iorodeo/buckpuck_current_controller/images/buckpuck_current_controller_front.jpg

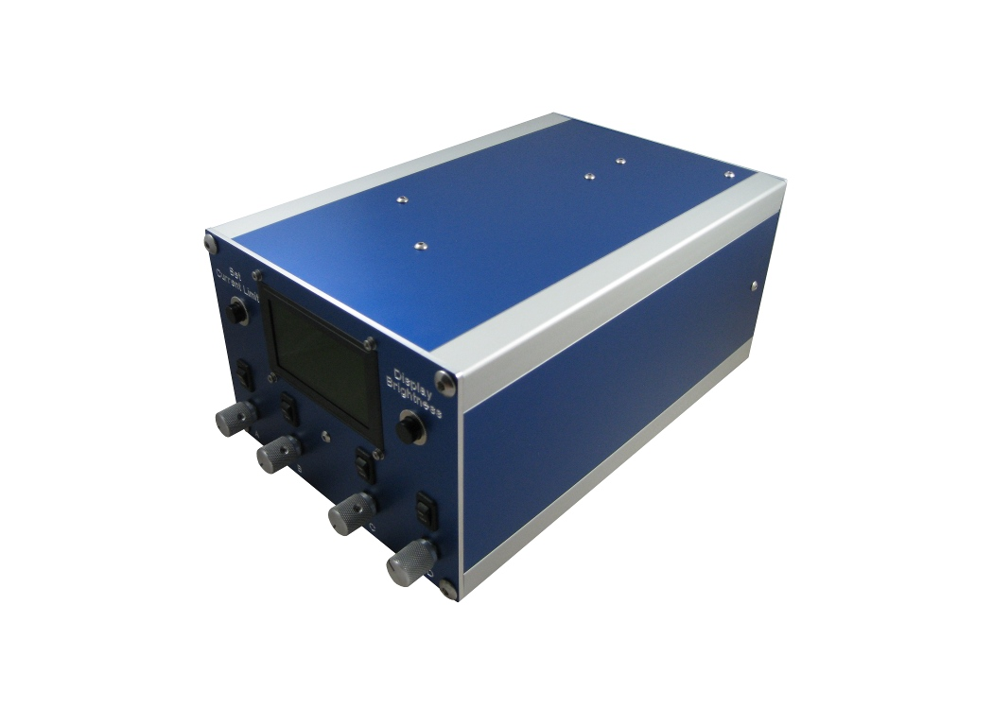
images/buckpuck_current_controller_front.jpg
