iorodeo/buckpuck_current_controller/datasheets/current_sensor_board.png

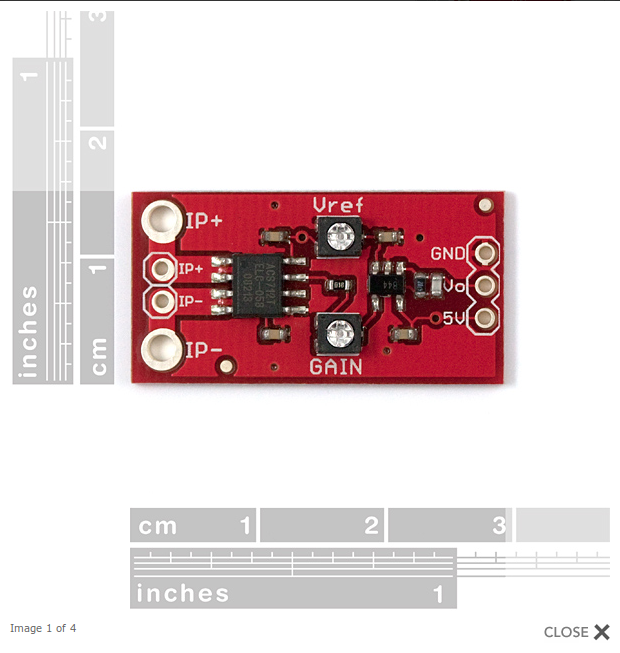
datasheets/current_sensor_board.png
