iorodeo/buckpuck_current_controller/images/buckpuck_current_controller_back.jpg

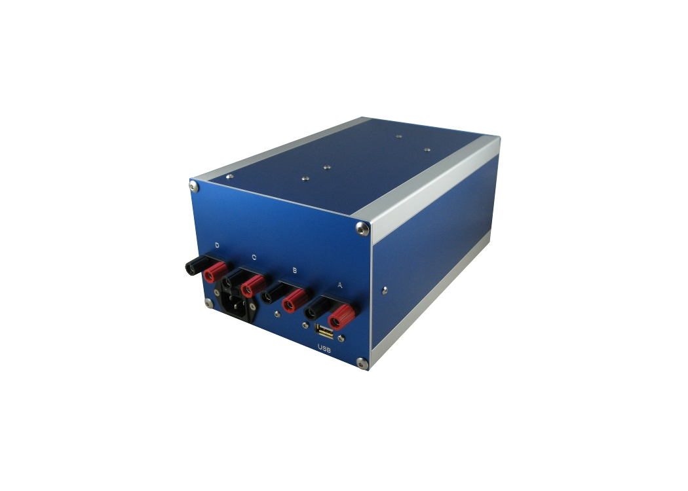
images/buckpuck_current_controller_back.jpg
