iorodeo/buckpuck_current_controller/images/buckpuck_current_controller_inside.jpg

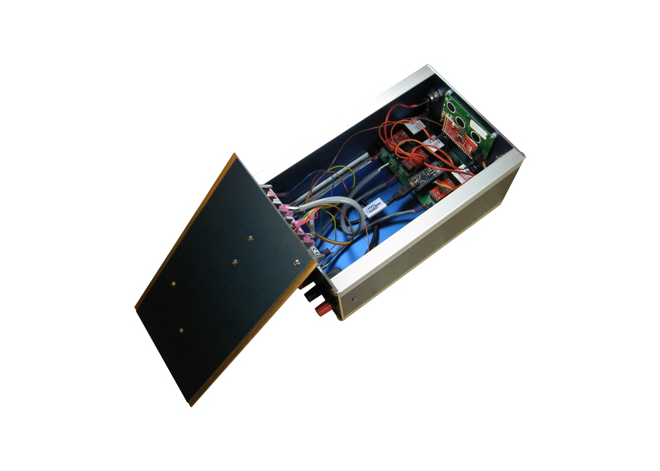
images/buckpuck_current_controller_inside.jpg
