iorodeo/buckpuck_current_controller/enclosure/enclosure_back.dxf

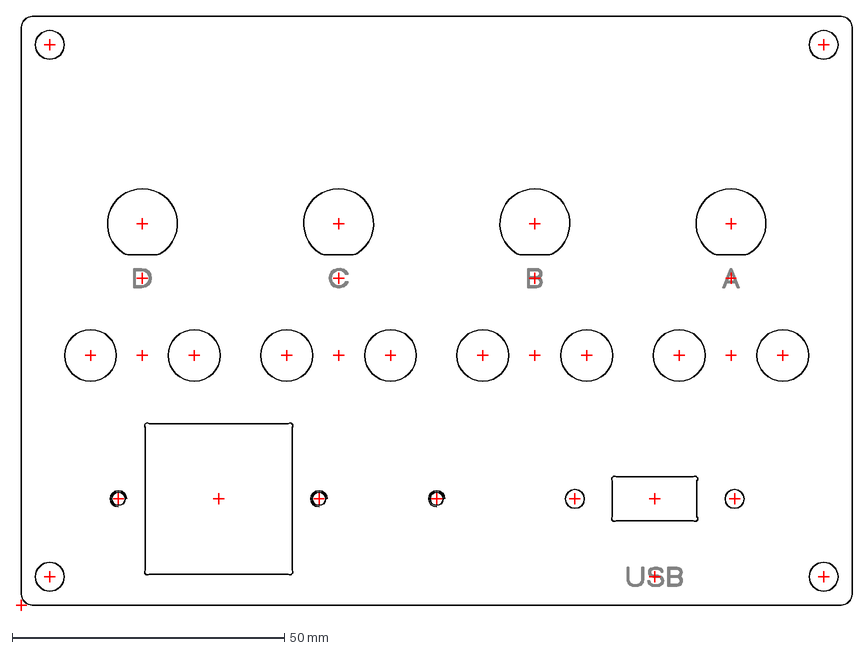
[picture p5: CAD file, 2011-09-08]
enclosure/enclosure_back.dxf
153.4 x 109.0 mm
