iorodeo/buckpuck_current_controller/datasheets/dac_wiring.gif

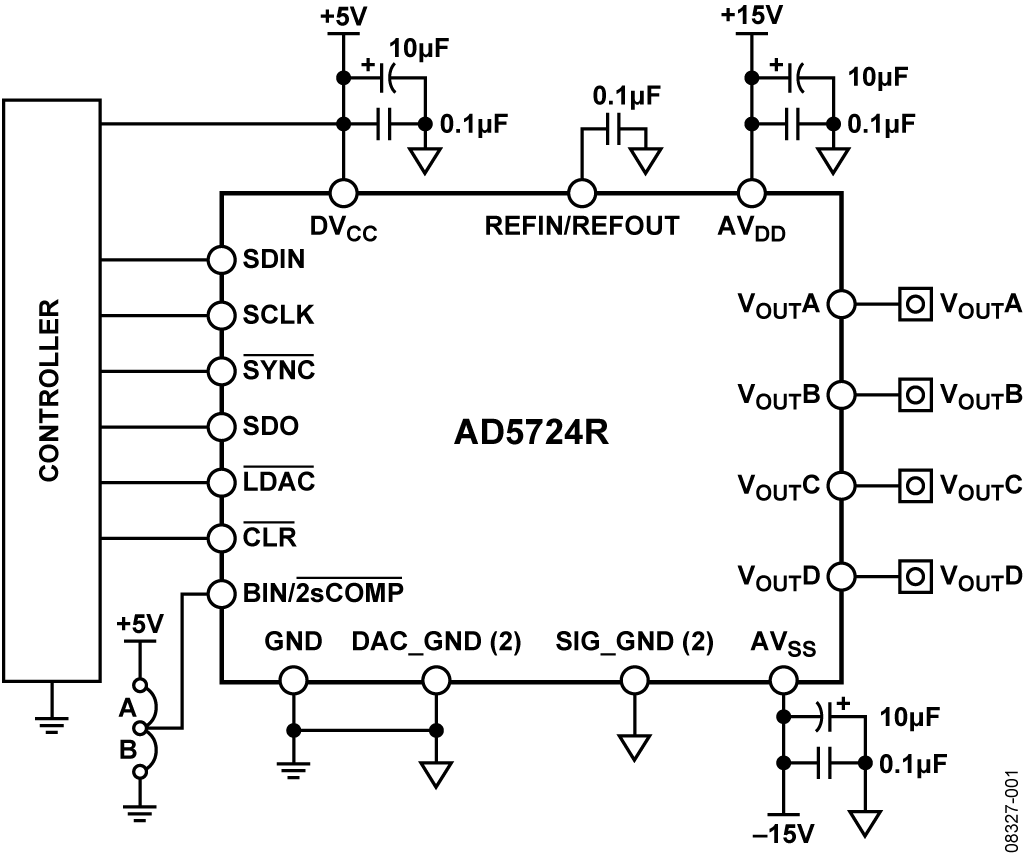
datasheets/dac_wiring.gif
