iorodeo/buckpuck_current_controller/(list of files, drawings)

Other design files:
pcb/buckpuck_current_controller.dsn
