iorodeo/buckpuck_current_controller/pcb/buckpuck_current_controller.sch

## KiCad design pcb/buckpuck_current_controller.sch (2011-08-04)

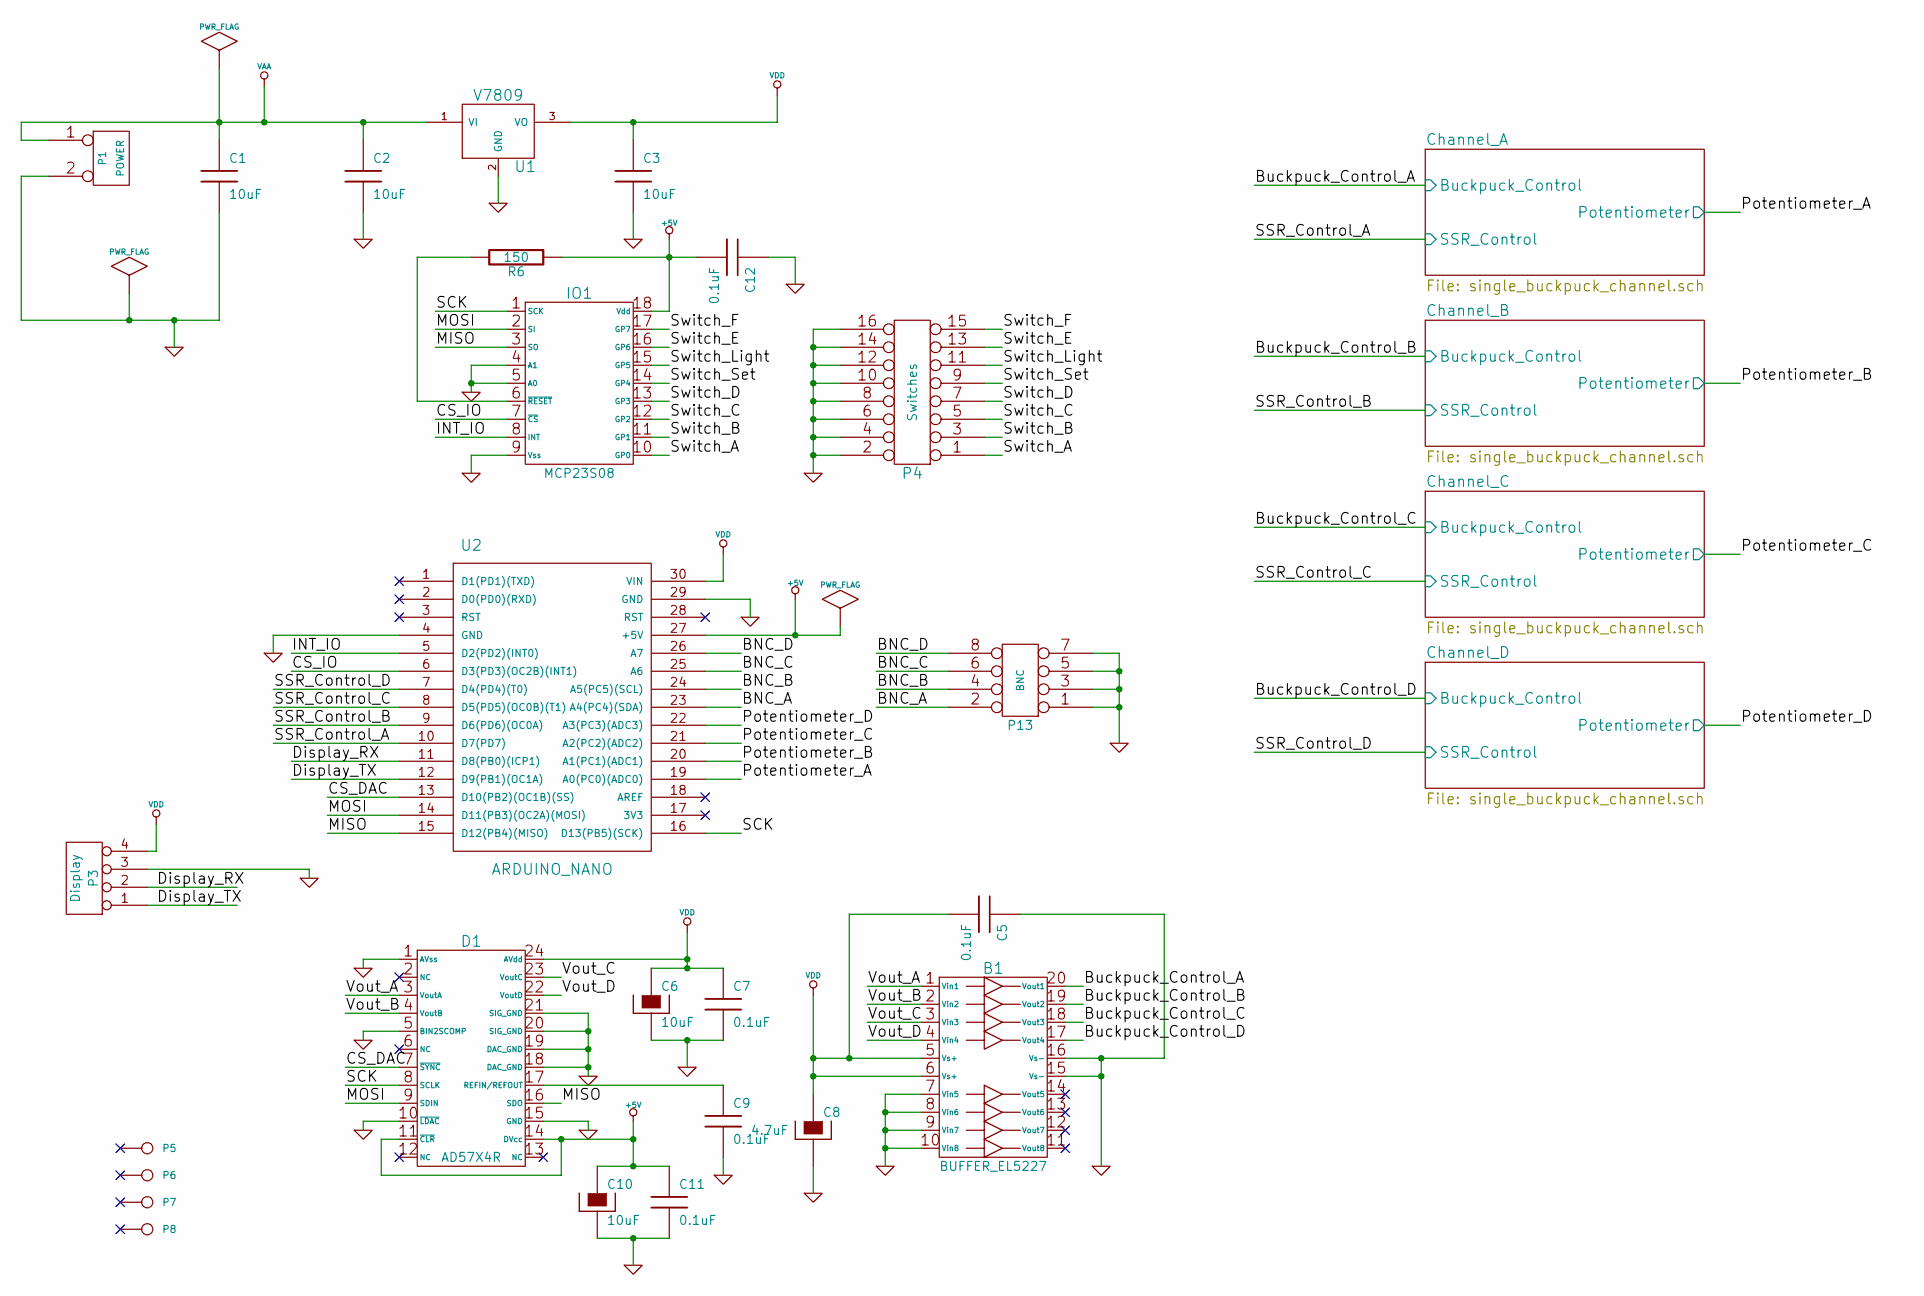
[picture p7: schematic buckpuck_current_controller.sch]

Parts:
B1: BUFFER_EL5227
C1, C2, C3, C6, C10: 10uF
C5, C7, C9, C11, C12: 0.1uF
C8: 4.7uF
D1: AD57X4R
IO1: MCP23S08
P1: POWER
P3: Display
P4: Switches
P5, P6, P7, P8: CONN_1
P13: BNC
R6: 150
U1: V7809
U2: ARDUINO_NANO

Connections:
+5V: C10.1, C11.1, C12.2, D1.11 (~CLR), D1.14 (DVcc), IO1.18 (Vdd), R6.1, U2.27 (+5V)
BNC_A: P13.2, U2.23 (A4(PC4)(SDA))
BNC_B: P13.4, U2.24 (A5(PC5)(SCL))
BNC_C: P13.6, U2.25 (A6)
BNC_D: P13.8, U2.26 (A7)
Buckpuck_Control_A: B1.20 (Vout1)
Buckpuck_Control_B: B1.19 (Vout2)
Buckpuck_Control_C: B1.18 (Vout3)
Buckpuck_Control_D: B1.17 (Vout4)
CS_DAC: D1.7 (~SYNC), U2.13 (D10(PB2)(OC1B)(SS))
CS_IO: IO1.7 (~CS), U2.6 (D3(PD3)(OC2B)(INT1))
Display_RX: P3.2, U2.11 (D8(PB0)(ICP1))
Display_TX: P3.1, U2.12 (D9(PB1)(OC1A))
GND: B1.7 (Vin5), B1.8 (Vin6), B1.9 (Vin7), B1.10 (Vin8), B1.15 (Vs-), B1.16 (Vs-), C1.2, C2.2, C3.2, C5.1, C6.2, C7.2, C8.2, C9.2, C10.2, C11.2, C12.1, D1.1 (AVss), D1.5 (BIN2SCOMP), D1.10 (~LDAC), D1.15 (GND), D1.18 (DAC_GND), D1.19 (DAC_GND), D1.20 (SIG_GND), D1.21 (SIG_GND), IO1.4 (A1), IO1.5 (A0), IO1.9 (Vss), P1.2 (PM), P3.3, P4.2, P4.4, P4.6, P4.8, P4.10, P4.12, P4.14, P4.16, P13.1, P13.3, P13.5, P13.7, U1.2 (GND), U2.4 (GND), U2.29 (GND)
INT_IO: IO1.8 (INT), U2.5 (D2(PD2)(INT0))
MISO: D1.16 (SDO), IO1.3 (SO), U2.15 (D12(PB4)(MISO))
MOSI: D1.9 (SDIN), IO1.2 (SI), U2.14 (D11(PB3)(OC2A)(MOSI))
unnamed: C9.1, D1.17 (REFIN/REFOUT)
unnamed: IO1.6 (~RESET), R6.2
Potentiometer_A: U2.19 (A0(PC0)(ADC0))
Potentiometer_B: U2.20 (A1(PC1)(ADC1))
Potentiometer_C: U2.21 (A2(PC2)(ADC2))
Potentiometer_D: U2.22 (A3(PC3)(ADC3))
SCK: D1.8 (SCLK), IO1.1 (SCK), U2.16 (D13(PB5)(SCK))
SSR_Control_A: U2.10 (D7(PD7))
SSR_Control_B: U2.9 (D6(PD6)(OC0A))
SSR_Control_C: U2.8 (D5(PD5)(OC0B)(T1))
SSR_Control_D: U2.7 (D4(PD4)(T0))
Switch_A: IO1.10 (GP0), P4.1
Switch_B: IO1.11 (GP1), P4.3
Switch_C: IO1.12 (GP2), P4.5
Switch_D: IO1.13 (GP3), P4.7
Switch_E: IO1.16 (GP6), P4.13
Switch_F: IO1.17 (GP7), P4.15
Switch_Light: IO1.15 (GP5), P4.11
Switch_Set: IO1.14 (GP4), P4.9
VAA: C1.1, C2.1, P1.1, U1.1 (VI)
VDD: B1.5 (Vs+), B1.6 (Vs+), C3.1, C5.2, C6.1, C7.1, C8.1, D1.24 (AVdd), P3.4, U1.3 (VO), U2.30 (VIN)
Vout_A: B1.1 (Vin1), D1.3 (VoutA)
Vout_B: B1.2 (Vin2), D1.4 (VoutB)
Vout_C: B1.3 (Vin3), D1.23 (VoutC)
Vout_D: B1.4 (Vin4), D1.22 (VoutD)
