iorodeo/buckpuck_current_controller/pcb/single_buckpuck_channel.sch

## KiCad design pcb/single_buckpuck_channel.sch (2011-08-04)

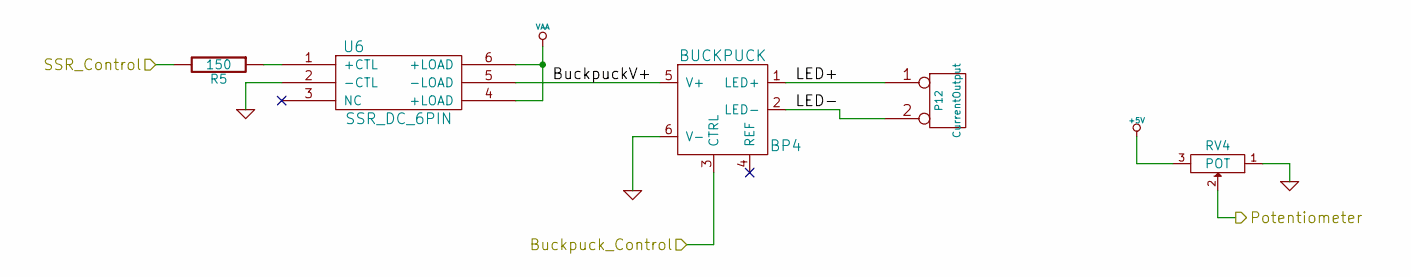
[picture p8: schematic single_buckpuck_channel.sch]

Parts:
BP4: BUCKPUCK
P12: CurrentOutput
R2: 150
RV4: POT
U3: SSR_DC_6PIN

Connections:
+5V: RV4.3
BuckpuckV+: BP4.5 (V+), U3.5 (-LOAD)
Buckpuck_Control: BP4.3 (CTRL)
GND: BP4.6 (V-), RV4.1, U3.2 (-CTL)
LED+: BP4.1 (LED+), P12.1
LED-: BP4.2 (LED-), P12.2 (PM)
unnamed: R2.1, U3.1 (+CTL)
Potentiometer: RV4.2
SSR_Control: R2.2
VAA: U3.4 (+LOAD), U3.6 (+LOAD)
