iorodeo/buckpuck_current_controller/firmware/buckpuck_current_controller/channel.cpp

// ----------------------------------------------------------------------------
// channel.cpp
//
// Object to control each channel of the current controller.
//
// Author: Peter Polidoro, IO Rodeo Inc.
// ----------------------------------------------------------------------------
#include "WProgram.h"
#include <Streaming.h>
#include "channel.h"

//---------- constructor ----------------------------------------------------

// Channel::Channel() {
//   setMode(OFF_MODE);
// }

Channel::Channel(IOPin & onOffSwitch, IOPin & relayEnable, IOPin & potentiometer, IOPin & dac, IOPin & bnc, int eepromAddressCurrentLimit, int eepromAddressBncMode):
  mode(OFF_MODE), onOffSwitch(onOffSwitch), relayEnable(relayEnable), potentiometer(potentiometer), dac(dac), bnc(bnc), eepromAddressCurrentLimit(eepromAddressCurrentLimit), eepromAddressBncMode(eepromAddressBncMode),
  currentValue(0), currentLimit(CURRENT_VALUE_MIN), updateValue(0), initialSetValue(0), currentLimitNeedsSaving(false), bncMode(false), initialized(false)
{
  currentLimit = getSavedCurrentLimit();
  bncMode = getSavedBncMode();
  initialized = true;
}

//---------- public ----------------------------------------------------

// ----------------------------------------------------------------------------
// Channel::setMode
//
// Set the channel mode.
// ----------------------------------------------------------------------------
void Channel::setMode(modes mode) {
  if (mode != this->mode) {
    this->mode = mode;
    switch (mode) {
    case ON_MODE: setModeOn(); break;
    case OFF_MODE: setModeOff(); break;
    case SET_MODE: setModeSet(); break;
    case CC_MODE: setModeCC(); break;
    case BNC_MODE: setModeBnc(); break;
    }
  }
}

// ----------------------------------------------------------------------------
// Channel::getMode
//
// Get the channel mode.
// ----------------------------------------------------------------------------
Channel::modes Channel::getMode() {
  return mode;
}

// ----------------------------------------------------------------------------
// Channel::getPotentiometerValue
//
// Get the channel potentiometer value.
// ----------------------------------------------------------------------------
int Channel::getPotentiometerValue() {
  return potentiometer.read();
}

// ----------------------------------------------------------------------------
// Channel::getBncValue
//
// Get the channel bnc value.
// ----------------------------------------------------------------------------
int Channel::getBncValue() {
  return bnc.read();
}

// ----------------------------------------------------------------------------
// Channel::getOnOffSwitchValue
//
// Get the channel on/off switch value.
// ----------------------------------------------------------------------------
byte Channel::getOnOffSwitchValue() {
  return onOffSwitch.read();
}

// ----------------------------------------------------------------------------
// Channel::setCurrentValue
//
// Set the channel current value.
// ----------------------------------------------------------------------------
void Channel::setCurrentValue(int currentValue) {
  if (mode == CC_MODE) {
    this->currentValue = currentValue;
    setDacValue();
  }
}

// ----------------------------------------------------------------------------
// Channel::getCurrentValue
//
// Get the channel current value.
// ----------------------------------------------------------------------------
int Channel::getCurrentValue() {
  return currentValue;
}

// ----------------------------------------------------------------------------
// Channel::setCurrentLimit
//
// Set the channel current limit.
// ----------------------------------------------------------------------------
void Channel::setCurrentLimit(int currentLimit) {
  if (mode == CC_MODE) {
    this->currentLimit = currentLimit;
    currentLimitNeedsSaving = true;
  }
}

// ----------------------------------------------------------------------------
// Channel::getCurrentLimit
//
// Get the channel current limit.
// ----------------------------------------------------------------------------
int Channel::getCurrentLimit() {
  return currentLimit;
}

// ----------------------------------------------------------------------------
// Channel::update
//
// Update the channel based on the mode, given the update value.
// ----------------------------------------------------------------------------
void Channel::update(int updateValue) {
  this->updateValue = updateValue;
  switch (mode) {
  case ON_MODE:
    currentValue = map(updateValue,UPDATE_VALUE_MIN,UPDATE_VALUE_MAX,CURRENT_VALUE_MIN,currentLimit);
    setDacValue();
    break;
  case OFF_MODE:
    break;
  case SET_MODE:
    if (SET_DEADBAND < abs(updateValue - initialSetValue)) {
      currentLimit = map(updateValue,UPDATE_VALUE_MIN,UPDATE_VALUE_MAX,CURRENT_VALUE_MIN,CURRENT_VALUE_MAX);
      currentLimitNeedsSaving = true;
    }
    break;
  case CC_MODE:
    break;
  case BNC_MODE:
    currentValue = map(updateValue,UPDATE_VALUE_MIN,UPDATE_VALUE_MAX,CURRENT_VALUE_MIN,currentLimit);
    setDacValue();
    break;
  }
}

// ----------------------------------------------------------------------------
// Channel::setSavedBncMode
//
// Save bncMode to EEPROM and class variable.
// ----------------------------------------------------------------------------
void Channel::setSavedBncMode(bool bncMode) {
  this->bncMode = bncMode;
  EEPROM.write(eepromAddressBncMode,bncMode);
}

// ----------------------------------------------------------------------------
// Channel::getSavedBncMode
//
// Get the channel bnc mode.
// ----------------------------------------------------------------------------
bool Channel::getSavedBncMode() {
  if (!initialized) {
    byte eepromValue = EEPROM.read(eepromAddressBncMode);
    bncMode = bool(eepromValue);
  }
  return bncMode;
}

//------------------ private -----------------------------------------------

// ----------------------------------------------------------------------------
// Channel::enableRelay
//
// Enable relay.
// ----------------------------------------------------------------------------
void Channel::enableRelay() {
  relayEnable.write(HIGH);
}

// ----------------------------------------------------------------------------
// Channel::disableRelay
//
// Disable relay.
// ----------------------------------------------------------------------------
void Channel::disableRelay() {
  relayEnable.write(LOW);
}

// ----------------------------------------------------------------------------
// Channel::setDacValue
//
// Set DAC given currentValue.
// ----------------------------------------------------------------------------
void Channel::setDacValue() {
  if (currentValue < CURRENT_DAC_OFF) {
    setDacOff();
  }
  else {
    int dacValue = map(currentValue,CURRENT_VALUE_MIN,CURRENT_VALUE_MAX,DAC_VALUE_MIN,DAC_VALUE_MAX);
    dac.write(dacValue);
  }
  
}

// ----------------------------------------------------------------------------
// Channel::setDacOff
//
// Set DAC to OFF dac value.
// ----------------------------------------------------------------------------
void Channel::setDacOff() {
  dac.write(DAC_VALUE_OFF);
}

// ----------------------------------------------------------------------------
// Channel::setModeOn
//
// Enable relay and set DAC.
// ----------------------------------------------------------------------------
void Channel::setModeOn() {
  setDacValue();
  enableRelay();
  if (currentLimitNeedsSaving) {
    currentLimitNeedsSaving = false;
    setSavedCurrentLimit();
  }
}

// ----------------------------------------------------------------------------
// Channel::setModeOff
//
// Set DAC OFF and disable relay.
// ----------------------------------------------------------------------------
void Channel::setModeOff() {
  currentValue = CURRENT_VALUE_MIN;
  setDacOff();
  disableRelay();
  if (currentLimitNeedsSaving) {
    currentLimitNeedsSaving = false;
    setSavedCurrentLimit();
  }
}

// ----------------------------------------------------------------------------
// Channel::setModeSet
//
// SetModeOff
// ----------------------------------------------------------------------------
void Channel::setModeSet() {
  initialSetValue = updateValue;
  setModeOff();
}

// ----------------------------------------------------------------------------
// Channel::setModeCC
//
// SetModeOn
// ----------------------------------------------------------------------------
void Channel::setModeCC() {
  setModeOn();
}

// ----------------------------------------------------------------------------
// Channel::setModeBnc
//
// SetModeBnc
// ----------------------------------------------------------------------------
void Channel::setModeBnc() {
  setModeOn();
}

// ----------------------------------------------------------------------------
// Channel::setSavedCurrentLimit
//
// Save currentLimit to EEPROM after remapping.
// ----------------------------------------------------------------------------
void Channel::setSavedCurrentLimit() {
  byte eepromValue = map(currentLimit,CURRENT_VALUE_MIN,CURRENT_VALUE_MAX,EEPROM_VALUE_MIN,EEPROM_VALUE_MAX);
  EEPROM.write(eepromAddressCurrentLimit,eepromValue);
}

// ----------------------------------------------------------------------------
// Channel::getSavedCurrentLimit
//
// Get saved from EEPROM and remap to currentLimit.
// ----------------------------------------------------------------------------
int Channel::getSavedCurrentLimit() {
  byte eepromValue = EEPROM.read(eepromAddressCurrentLimit);
  return map(eepromValue,EEPROM_VALUE_MIN,EEPROM_VALUE_MAX,CURRENT_VALUE_MIN,CURRENT_VALUE_MAX);
}
