iorodeo/buckpuck_current_controller/(commit log)

2011-04-20 Initial commit.
    [buckpuck_current_controller.brd, buckpuck_current_controller.sch]
2011-04-22 Added some components to the schematic
    [buckpuck_current_controller.sch]
2011-05-17 Added single_buckpuck_channel.sch and some datasheets
    [buckpuck_current_controller.sch, single_buckpuck_channel.sch]
2011-05-18 Finished schematic design, added new datasheets...
    [buckpuck_current_controller.sch, single_buckpuck_channel.sch]
2011-05-18 Finished netlist, begun laying out board. Added datasheets.
    [$savepcb.brd, buckpuck_current_controller.sch, single_buckpuck_channel.sch]
2011-05-20 Placed components on board, still finishing routing...
    [$savepcb.brd, buckpuck_current_controller.brd, buckpuck_current_controller.dsn]
2011-05-21 Finished routing board. Examine one more time before being made.
    [$savepcb.brd, buckpuck_current_controller.brd, buckpuck_current_controller.sch, single_buckpuck_channel.sch]
2011-05-22 Modified board layout, corrected some placement errors
    [$savepcb.brd, buckpuck_current_controller.brd]
2011-05-23 Finished board layout v1.
    [$savepcb.brd, buckpuck_current_controller.brd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]
2011-05-24 Modified board and created version 1.1. Created bill of materials
    [$savepcb.brd, buckpuck_current_controller.brd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]
2011-05-25 Finished version 1.1
    [buckpuck_current_controller.brd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]
2011-05-31 Moved directories, started enclosure design.
2011-06-01 Added sides to the enclosure.
2011-06-04 Added buckpuck_current_controller Arduino firmware.
2011-06-08 Modified schematic, board, and enclosure files
    [$savepcb.brd, buckpuck_current_controller.brd, buckpuck_current_controller.sch, buckpuck_current_controller_v1.brd, single_buckpuck_channel.sch]
2011-06-08 Almost finished with version 2 board.
    [$savepcb.brd, buckpuck_current_controller.brd, buckpuck_current_controller.dsn, buckpuck_current_controller.sch]
2011-06-09 Completed board design version 2.
    [$savepcb.brd, buckpuck_current_controller.brd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]
2011-06-25 Added photo and simulation of buckpuck voltage input to current output
2011-07-12 Initial changes for version-3 design
    [buckpuck_current_controller.sch, single_buckpuck_channel.sch]
2011-07-13 Finished schematic version 3
    [buckpuck_current_controller.brd, buckpuck_current_controller.dsn, buckpuck_current_controller.sch, single_buckpuck_channel.sch]
2011-07-14 Made changes to schematic, board, and bom
    [buckpuck_current_controller.brd, buckpuck_current_controller.sch, single_buckpuck_channel.sch]
2011-07-15 Finished version 3
    [$savepcb.brd, buckpuck_current_controller.brd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]
2011-07-15 Final changes for version 3.0
    [buckpuck_current_controller.brd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]
2011-07-25 Updated footprint for high current DC jack
    [buckpuck_current_controller.brd]
2011-07-28 Modified firmware to work with version 3 boards
2011-07-31 Creating version-4
    [buckpuck_current_controller.sch, single_buckpuck_channel.sch]
2011-07-31 Made intial version-4 changes to the schematic
    [buckpuck_current_controller.sch, single_buckpuck_channel.sch]
2011-08-03 Added IO expander to the schematic
    [buckpuck_current_controller.sch, single_buckpuck_channel.sch]
2011-08-04 Finished version-4 schematic and board design
    [$savepcb.brd, buckpuck_current_controller.brd, buckpuck_current_controller.dsn, buckpuck_current_controller.sch, single_buckpuck_channel.sch]
2011-08-04 Finished version-4, schematic, board, and gerbers
    [$savepcb.brd, buckpuck_current_controller.brd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]
2011-08-13 Added assembly_instructions.txt
2011-08-16 Modified firmware in an attempt to eliminate current 'blips'
2011-09-03 Added datasheet for 16 pin external IO, just for reference when developing driver.
2011-09-08 Modified enclosure back plate to add holes for BNC connectors
    [enclosure_back.dxf]
2011-10-12 Updated firmware, fixed bugs using ATOMIC statements.
    [ControllerDefines.h, buckpuck_current_controller.pde, ioPin.cpp]
2011-10-16 Updated current controller python interface.
2011-10-18 Fixed bug with initial EEPROM initialization.
    [buckpuck_current_controller.pde, channel.cpp]
2011-12-10 Organized host serial library into a python package. Clean up current_controller.py a bit. Added Licenses.
2011-12-13 Fixed bug in firmware which caused occassional corruption of serial messages from host PC. Note, had to disable updates of LCD display during "computer control" mode.
    [buckpuck_current_controller.pde, display.cpp, display.h]
2011-12-13 Fixed bug in GUI which causes the LCD display not to reset to stand alone mode when the program is closed without closing the device.
    [current_controller_app.py]
2011-12-13 Reomved unused timer sleep from current_controller_app.
2011-12-13 Fixed bug in GUI - channel group boxes were not unchecked on device close.
    [current_controller_app.py]
2011-12-14 Added example demonstrating web server interface to controller, based on flask web framework.
2011-12-14 Added examples demonstrating how to use set current values from Matlab using the flask based web server for the LED controller.
2012-03-09 Added try statement around import current_controller_app so that the serial interface can be used without pyqt4 being installed.
2012-03-19 Fixed low(off) blinking issue.
    [ControllerDefines.h, channel.cpp]
